seongjun-k/smart-battery-manager/cad/img/back_closed.png

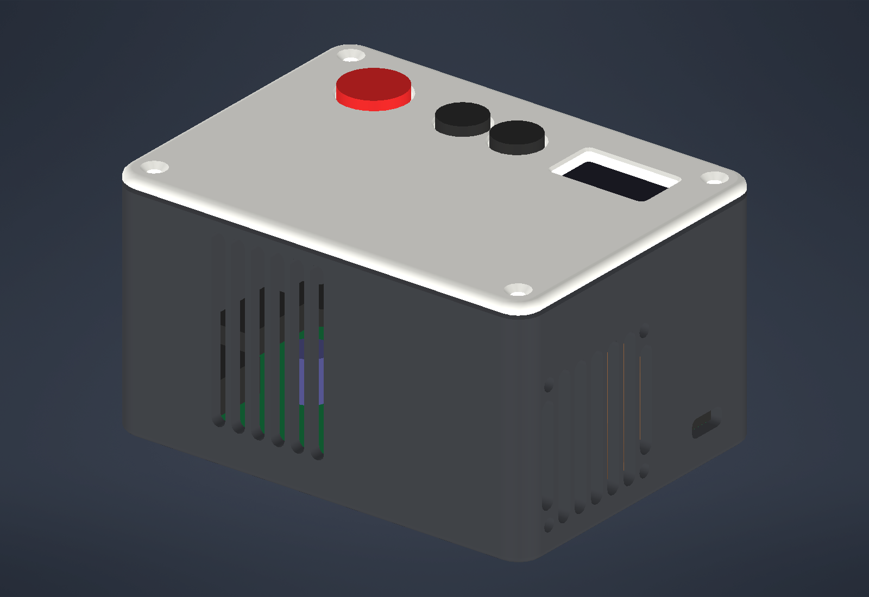
cad/img/back_closed.png
