seongjun-k/smart-battery-manager/cad/img/iso_closed.png

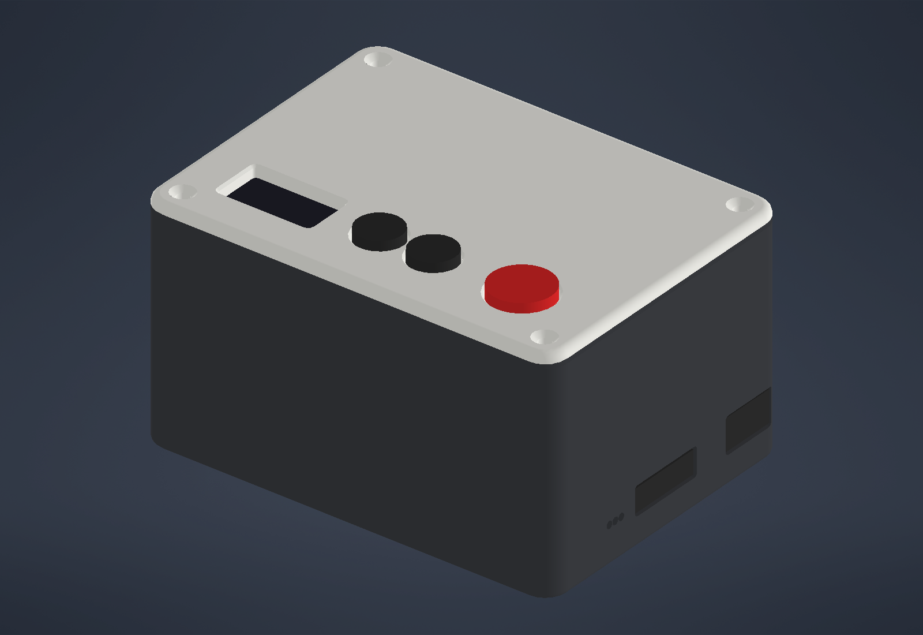
cad/img/iso_closed.png
