seongjun-k/smart-battery-manager/cad/img/top_open.png

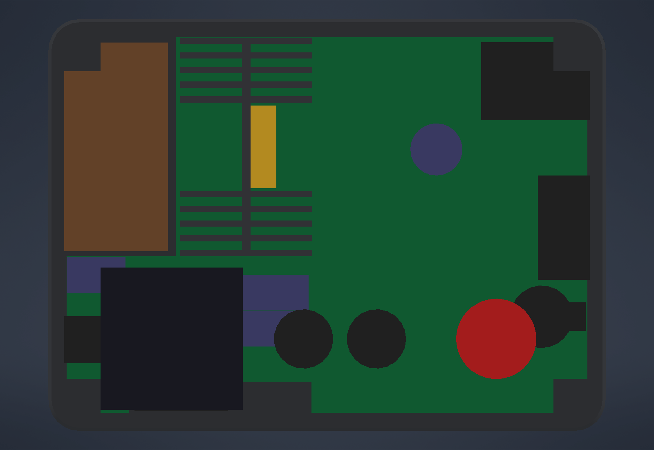
cad/img/top_open.png
