seongjun-k/smart-battery-manager/docs/img/dataflow.png

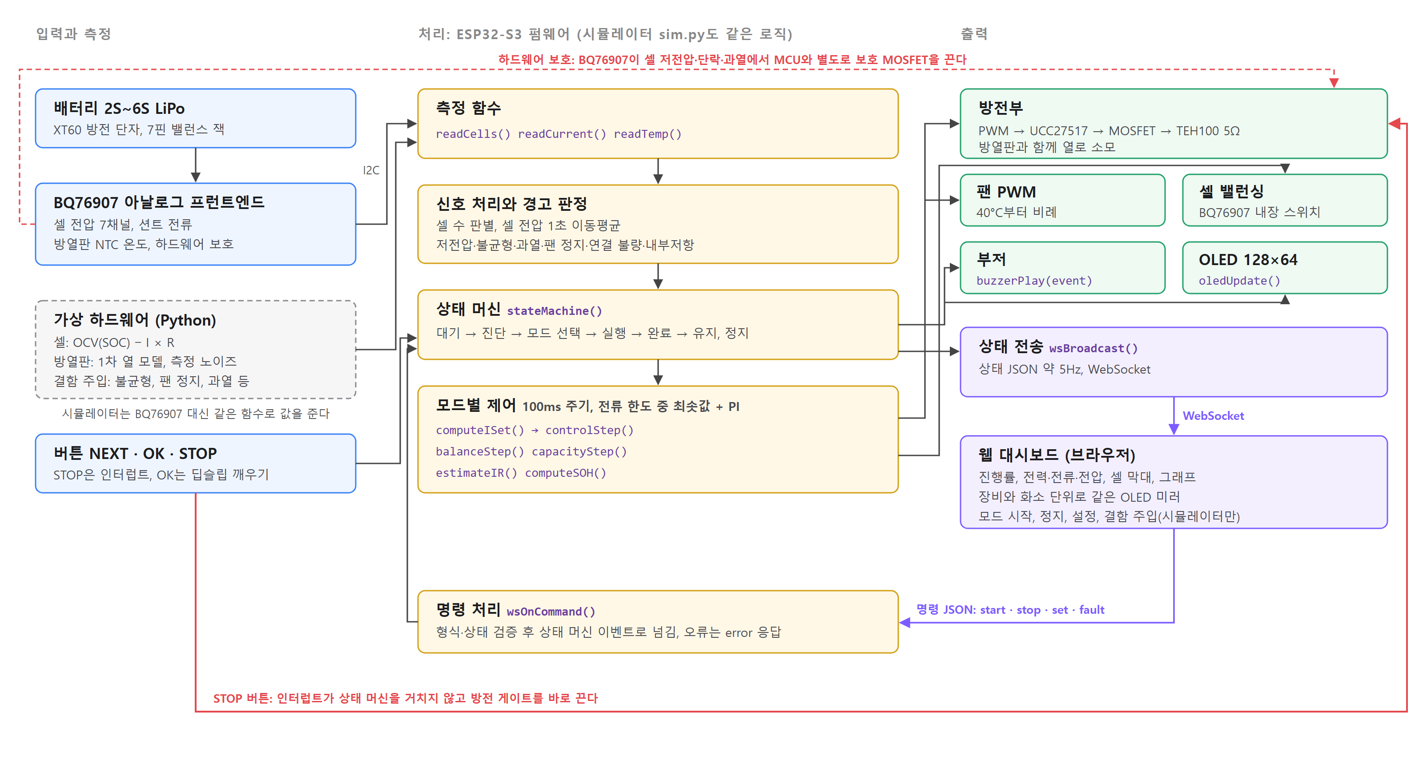
docs/img/dataflow.png
