seongjun-k/smart-battery-manager/docs/img/pcb_3d_bottom.png

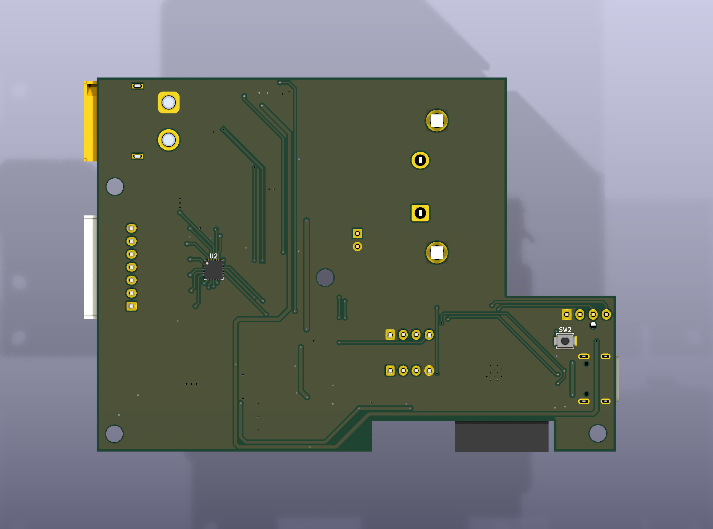
docs/img/pcb_3d_bottom.png
