seongjun-k/smart-battery-manager/docs/img/pcb_3d_top.png

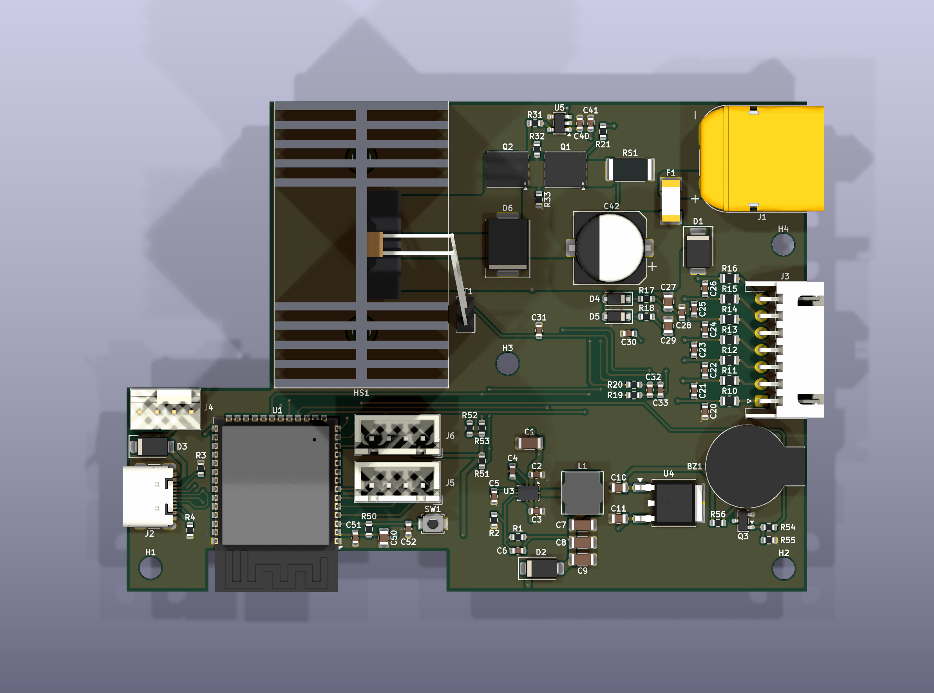
docs/img/pcb_3d_top.png
