seongjun-k/smart-battery-manager/docs/img/pcb_copper_bottom.png

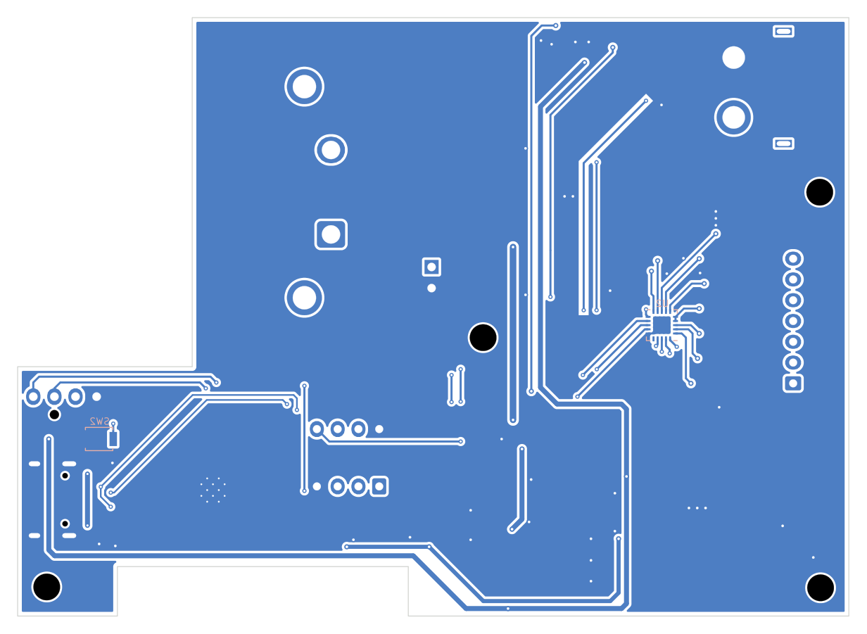
docs/img/pcb_copper_bottom.png
