seongjun-k/smart-battery-manager/docs/img/pcb_copper_top.png

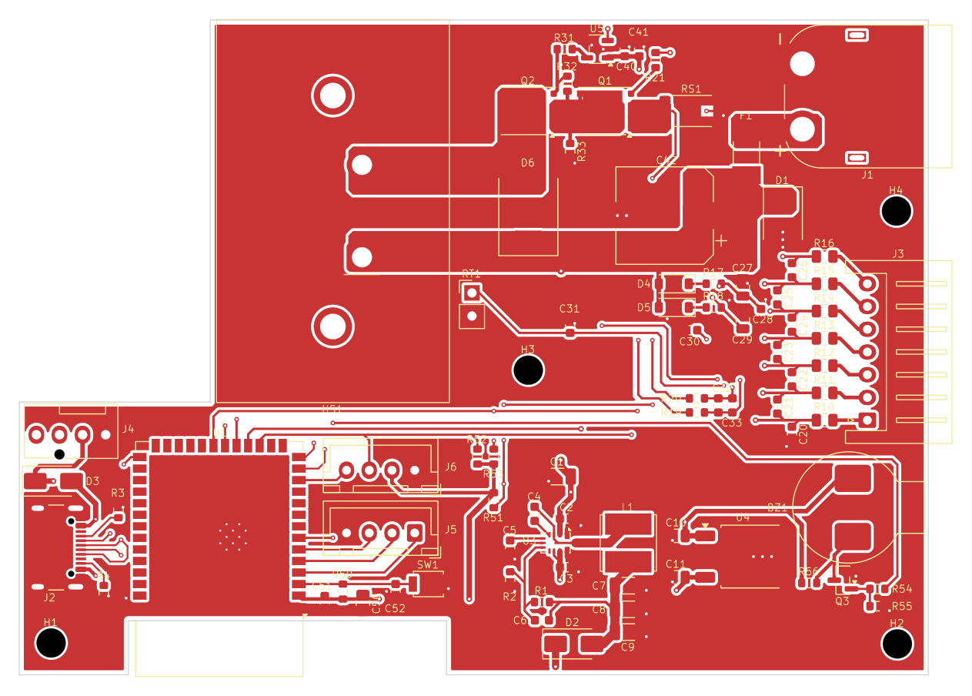
docs/img/pcb_copper_top.png
