seongjun-k/smart-battery-manager/docs/img/web_graph.png

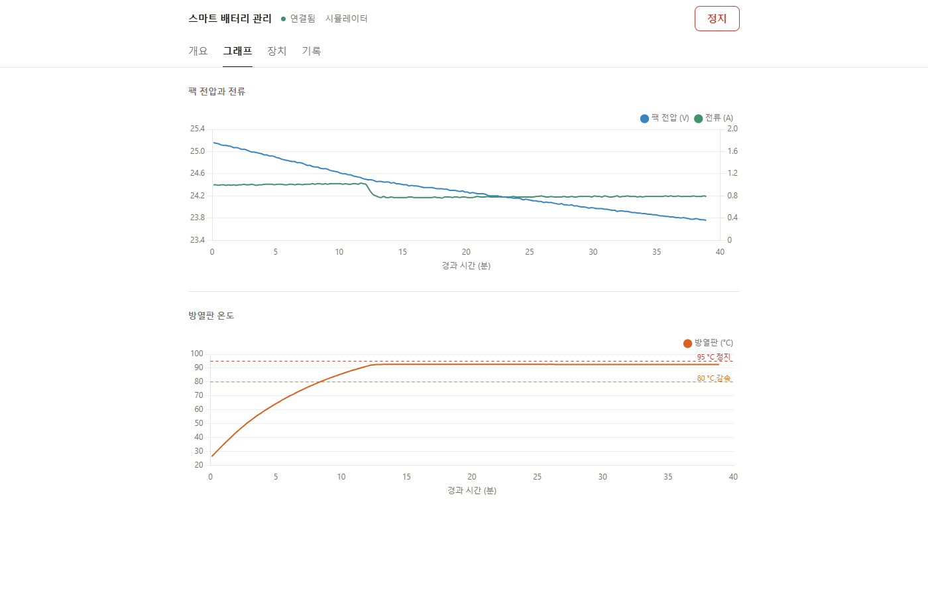
docs/img/web_graph.png
