seongjun-k/smart-battery-manager/docs/img/web_mobile.png

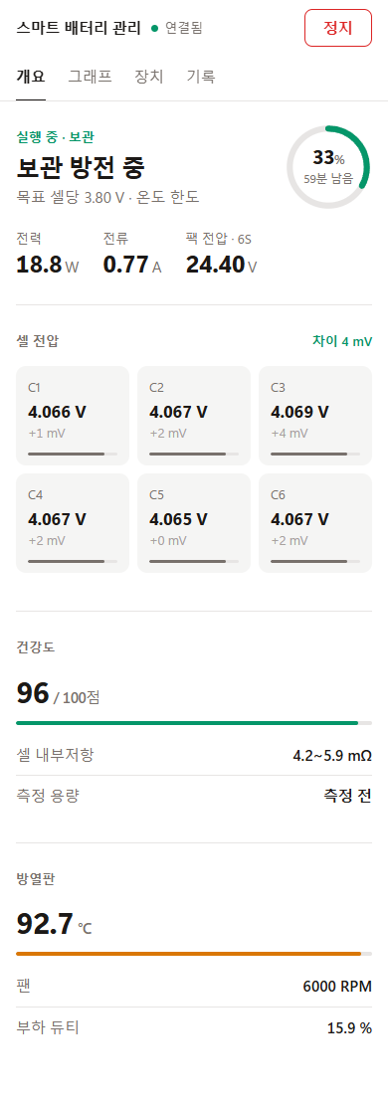
docs/img/web_mobile.png
