seongjun-k/smart-battery-manager/docs/img/web_run.png

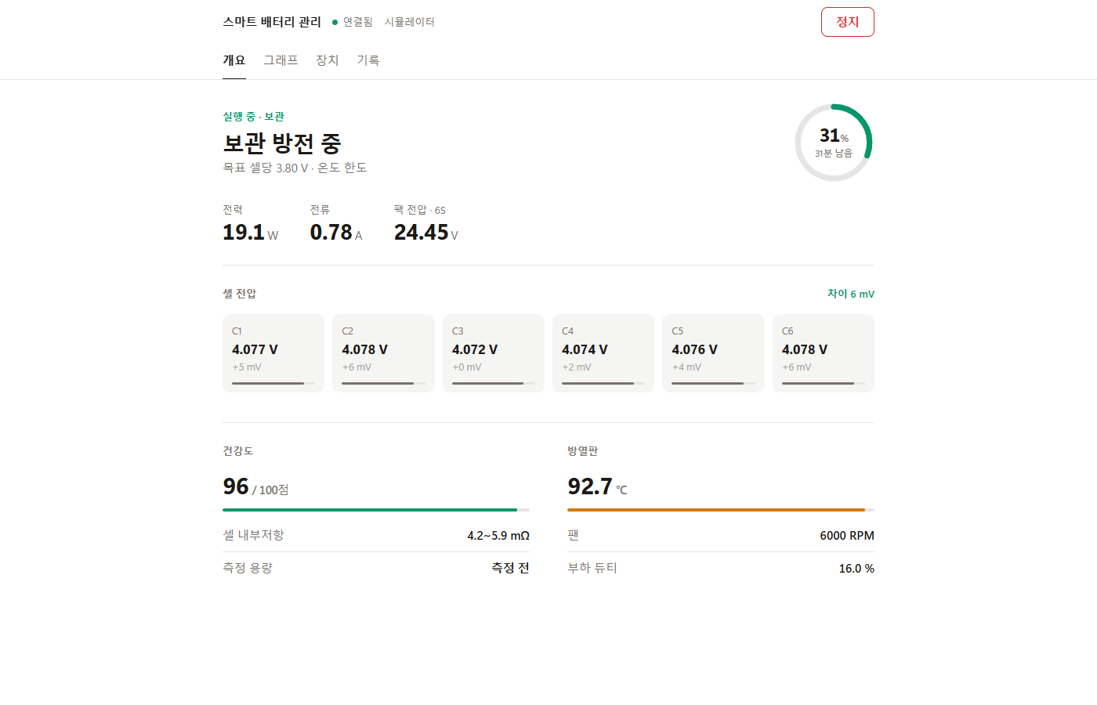
docs/img/web_run.png
