seongjun-k/smart-battery-manager/docs/img/web_select.png

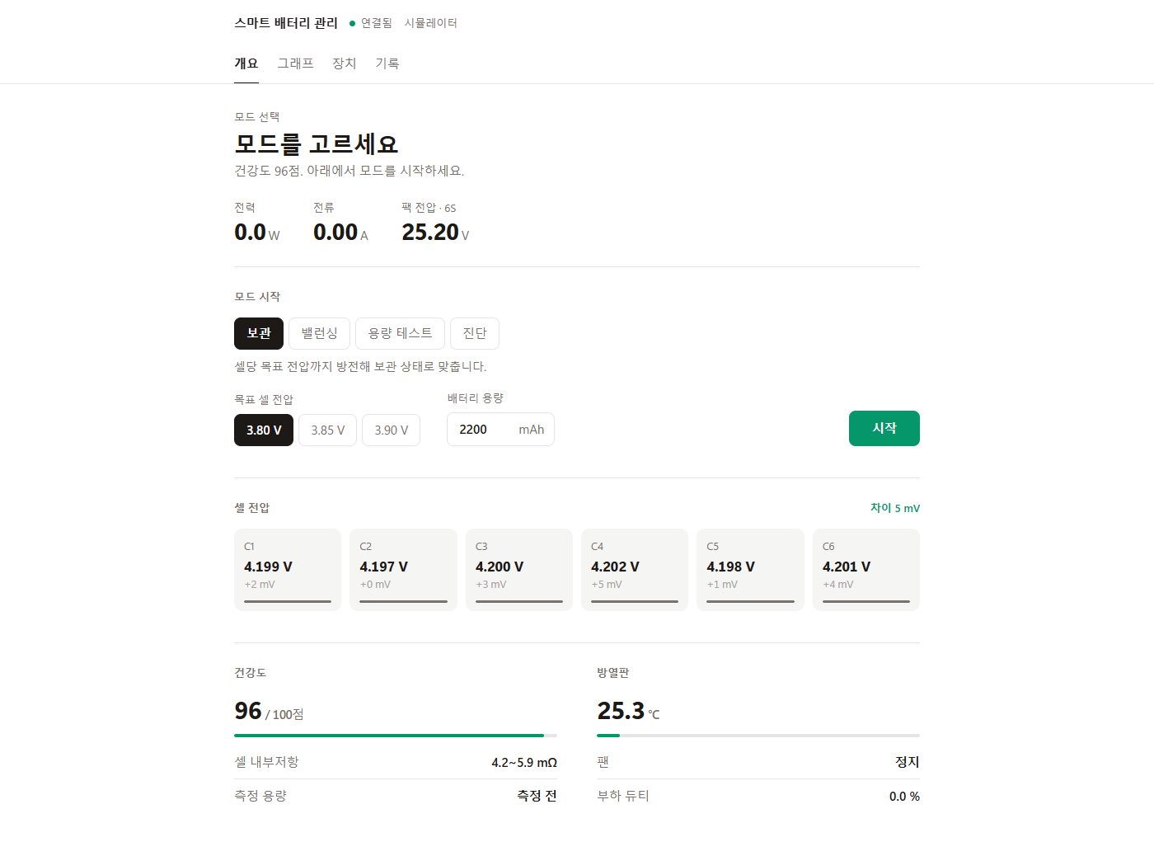
docs/img/web_select.png
