seongjun-k/smart-battery-manager/hw/3d/Fuse_Littelfuse-NANO2-451_453.step

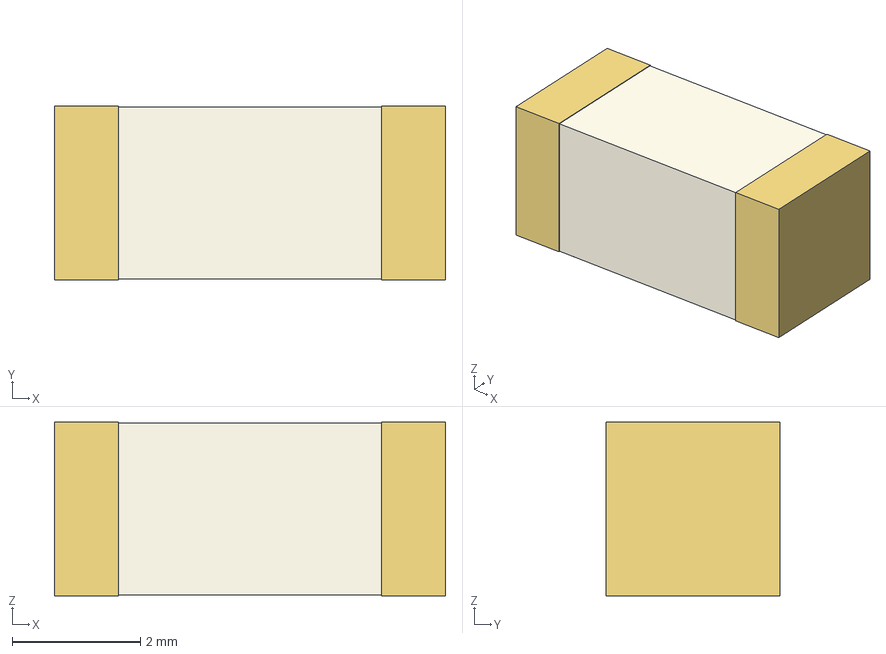
[picture p18: CAD file, 2026-10-30]
hw/3d/Fuse_Littelfuse-NANO2-451_453.step
6.10 x 2.71 x 2.71 mm
ceramic
cap_0
cap_1
