seongjun-k/smart-battery-manager/hw/3d/AMASS_XT60PW-M_1x02_P7.20mm_Horizontal.step

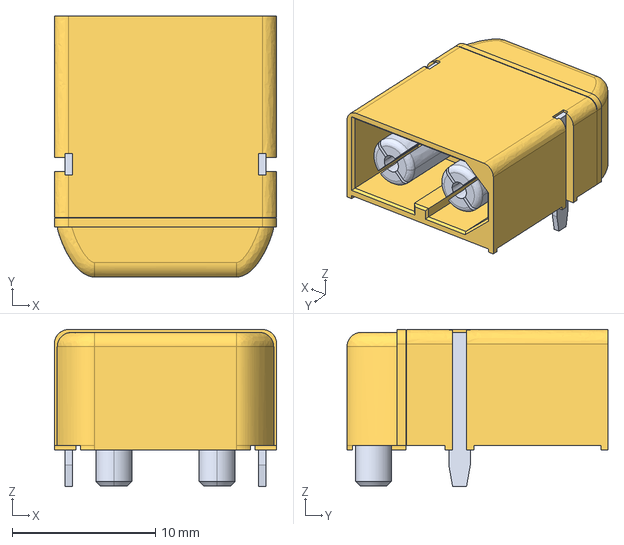
[picture p19: CAD file, 2026-10-30]
hw/3d/AMASS_XT60PW-M_1x02_P7.20mm_Horizontal.step
15.5 x 18.2 x 10.9 mm
