seongjun-k/smart-battery-manager/(list of files, cad)

Other CAD files:
cad/housing.iam
cad/housing_bottom.ipt
cad/housing_lid.ipt
cad/ref_fan.ipt
cad/ref_heatsink.ipt
cad/ref_oled.ipt
cad/ref_parts.ipt
cad/ref_pcb.ipt
cad/ref_resistor.ipt
cad/ref_stop.ipt
cad/ref_tall.ipt
