seongjun-k/smart-battery-manager/firmware/src/hal.h

#pragma once
// 상태 머신·제어 코드가 하드웨어를 보는 유일한 창구.
// 측정원(BQ76907, 이후 다른 AFE)과 출력 방식은 구현 파일(bq76907.cpp, io.cpp)이 숨긴다.
#include "config.h"

enum class Sound : uint8_t { KEY, START, DONE, STOP, WARN, ERROR };

// ---- 측정 (bq76907.cpp, io.cpp) ----
void readCells(float v[MAX_CELLS]);              // [V], 배터리 셀 1~n 순서(BQ 채널이 아님). 못 읽은 칸은 0
float readCurrent();                             // [A], 방전이 +
float readTemp();                                // [°C] 방열판 NTC 하나뿐. 읽기 실패 시 과열 값으로 반환(안전 쪽)
float readFanRpm();

// ---- 출력 (io.cpp, bq76907.cpp) ----
void setLoadDuty(float duty);                    // 0~1
void setFanDuty(float duty);                     // 0~1
void setBalance(const bool bal[MAX_CELLS], int n);   // bal[k] = 배터리 셀 k+1
void setDischargeAllowed(bool on);               // 보호 FET. 진단·실행 중에만 켠다. PWM과 따로 끊는 두 번째 경로
void buzzerPlay(Sound s);
