seongjun-k/smart-battery-manager/(commit log)

2026-10-20 과제 자료와 .gitignore 추가
    docs/에 과제 PDF, 계획서 v3, 결과보고서 초안, 인수인계 문서를 넣는다.
2026-10-20 Python 시뮬레이터 추가, 범위 확정에 맞춰 보고서 초안 갱신
    - sim/: 가상 배터리·열 모델, 제어 로직 이식, WebSocket 서버, 자체 점검
    - 보고서 초안: 이력 DB 제외, 모드 4개, 테스트 8종, 괄호 정리
    - 인수인계: 확정 결정과 남은 작업 갱신, 제출용 HWPX 양식 추가
2026-10-20 시뮬레이터에 밸런싱·용량 테스트 모드 추가, 테스트 8종
    - 밸런싱: 높은 셀만 내장 밸런싱, 1초 이동평균으로 완료 판정
    - 용량 테스트: 정전력 방전, 전하량 적산, 측정 용량을 SOH에 반영
    - batteryId 제거, SOH 식 변경, 과열 결함 +15°C
    - 보고서 7장 테스트 2~4, 6, 7 결과 기록
2026-10-20 웹 대시보드 추가, 시뮬레이터에 진행률·필터·경고 히스테리시스
    - web/: 다크 계기판 + OLED 미러 대시보드, Chart.js 4.5.1 로컬 포함
    - sim: 웹 정적 제공, progress/elapsed/bal/sim 필드, 셀 전압 1초 이동평균,
    불균형 경고 히스테리시스(50/40mV)
    - 보고서 4~7장, 인수인계 갱신
2026-10-20 ESP32-S3 펌웨어 추가, 재연결 필터 버그와 모드 선택 표시 수정
    - firmware/: PlatformIO(espressif32 8.0.0, Arduino 3.3.12), sim.py 제어 로직 이식,
    BQ76952 I2C 드라이버, OLED, AP 모드 웹/WebSocket, STOP ISR
    - 셀 전압 이동평균: 연결이 끊기면 비우고 재연결 시 첫 측정값부터 (sim·펌웨어)
    - 상태 메시지에 selMode 추가, OLED·웹 미러 모드 선택 화면에 표시
    - 보고서 4~7장, 인수인계 하드웨어 주의 사항 갱신
    [config.h, control.cpp, control.h, extra_script.py, hal.h, io.cpp, io.h, main.cpp]
2026-10-20 AFE를 BQ76907로 교체, 하드웨어 결정 반영 (2S~6S, 배터리 NTC 제거)
    - firmware: BQ76907 드라이버(TRM SLUUCJ0), 셀 채널 자동 매핑과 Vcell Mode,
    CUV 3.5V·SCD 8A·OTD 약 70°C·통신 워치독 하드웨어 보호, 완료 10분 뒤 딥슬립
    - sim/firmware/web: 배터리 온도 센서 제거, 밸런싱 동시 3셀(30mA),
    보관 후 자동 밸런싱, 충전 필요(3.70V) 알림, IR 25mΩ 초과 방전 거부, 2S 지원
    - 테스트 10종(IR 거부, 자동 밸런싱 추가)
    - 보고서 3장 부품 재선정(LMR36015, UCC27517, CSD18534Q5A 등), 2~7장, 인수인계 갱신
2026-10-20 방전부를 HS50 + PCB 세움형 방열판으로 바꾸고 Inventor 하우징 추가
    - 방전 저항 Arcol HS50 5Ω 50W 1개, 방열판 Fischer SK 409 63,5 STS, 팬 NF-A4x20 5V PWM
    - 기구를 PCB 한 장 가로 배치로 변경, 흡기 뒷면, 배기 왼쪽 옆면, 덮개에 OLED와 패널 버튼 3개
    - cad/build_housing.py: Inventor COM으로 하부·덮개·확인용 조립품 생성, 간섭 0건, 135x105x92.5mm
    - 보고서 3-1 부품표, 선정 이유, 열 설계, 3-2 크기·배치 갱신
    [housing.iam, housing_bottom.ipt, housing_lid.ipt, ref_fan.ipt, ref_heatsink.ipt, ref_oled.ipt, ref_parts.ipt, ref_pcb.ipt]
2026-10-20 방전 저항을 TEH100(TO-247) + 657-15ABPE로 바꾸고 방열판 기준 80→95°C
    - 방전 저항 Ohmite TEH100M5R00FE 5Ω, 방열판 Wakefield 657-15ABPE(솔더 핀)
    - 방열판 온도 감액 80→95°C, BQ76907 OTD 코드 18(약 96~99°C), sim 열저항 2.6/6.6
    - 보고서 3-1 부품표·선정 이유, 3-2 열 설계·크기 갱신
2026-10-20 KiCad 회로도와 PCB 부품 배치 추가, 하우징을 배치에 맞춤
    - hw/gen_schematic.py: 부품표에서 회로도(A3 4블록), 커스텀 심볼(BQ76907, LMR36015,
    UCC27517, AP7361C-33D)과 풋프린트(TEH100, 657-15ABPE) 생성. ERC 0건
    - 셀 결선을 TRM 표 5-8과 대조, 2S~5S 변환 케이블 결선표를 회로도에 표기
    - PCB 128x98mm(모서리 10mm 따냄), 91개 배치. BQ76907EVM·LMR36015 레이아웃 예 기준
    - 하우징: TO-247 + 657-15ABPE로 낮춘 이전 변경 포함, TEH100 리드 간격 10.16mm,
    PCB 고정 구멍을 팬 아래에서 옮김, ESP32 안테나를 앞 가장자리로. 간섭 0건
    - 인수인계 3~5장 갱신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
    [housing.iam, housing_bottom.ipt, housing_lid.ipt, ref_fan.ipt, ref_heatsink.ipt, ref_oled.ipt, ref_parts.ipt, ref_pcb.ipt]
2026-10-21 PCB 배선 완료, 미확정 부품 사양 확인 반영
    - 45° 자동 배선기 hw/autoroute45.py 추가, 전 넷 배선 + B.Cu GND 면
    - BQ76907을 아래면으로 옮겨 셀 배선 교차 제거, 노출 패드는 비아로 GND 연결
    - 벅 SW·VIN 구간을 레이아웃 예대로 손배선, C1·C2 방향 변경
    - 실크 참조 문자 재배치, 3D 모델 복구, 최소 홀 0.2mm (ESP32 열 비아)
    - 방열판 핀 위치, 팬 PWM, 퓨즈·다이오드·인덕터·NTC 사양을 데이터시트로 확정
    - 하우징 방열판을 657 실제 단면으로 다시 생성 (간섭 0건)
    - BQ76907 전류 갱신 주기 2.93ms 확인
    [housing.iam, housing_bottom.ipt, housing_lid.ipt, ref_fan.ipt, ref_heatsink.ipt, ref_oled.ipt, ref_parts.ipt, ref_pcb.ipt]
2026-10-22 회로도·PCB 100x72·하우징 전면 재설계, 부저를 BRS-03SC 피에조로 교체
    - 회로도를 블록 단위 실제 선으로 다시 그림 (ERC 0)
    - PCB 128x98 -> 100x72mm 재배치, 손배선 묶음(route_hand.py) + 45도 라우터로 재배선 (DRC 오류 0, 미연결 0)
    - 커넥터 J4/J5/J6/BZ1 가로 핀 줄 통일, 팬 커넥터를 USB 쪽으로, D2/D3 안쪽, 실크 0도 0.8mm 통일
    - 부저 BUJEON BRS-03SC 12mm 피에조 + XH 2핀 케이블, D7 대신 병렬 R56, TACH 풀업 R34 제거
    - 하우징 106x78x54.5 재생성 (간섭 0), 오른쪽 벽 소리 구멍
    [housing.iam, housing_bottom.ipt, housing_lid.ipt, ref_fan.ipt, ref_heatsink.ipt, ref_oled.ipt, ref_parts.ipt, ref_pcb.ipt]
2026-10-22 웹 대시보드 전면 재디자인, OLED 미러를 펌웨어 U8g2 글꼴로 화소 단위 일치
    - 계측기 앞판형 배치: 상태 흐름, 진행률 원형 막대, 전류 한도 표시, 팩 전압·전류 추세
    - 셀 세로 막대에 목표·3.50V 차단선, 최고·최저·밸런싱 표시
    - 장비 그림(OLED + NEXT/OK/STOP 버튼), 화면 구성 목록
    - 방열판 온도 그래프에 80°C 감속·95°C 차단선, 온도 구간 막대, 팬 회전 표시
    - 시작 불가 상태면 시작 버튼을 막고 이유 표시, 휴대폰 배치
    - tools/gen_oledfont.py: U8g2 5x8·6x12 글꼴을 web/oledfont.js로 풀어 넣음
    - 밸런싱 진행률을 완료 판정과 같은 이동평균 기준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
2026-10-22 보고서 그림 생성(회로도, PCB 배치·배선·3D, 데이터 흐름도, 웹 화면)과 보고서 빈칸 채우기
    - tools/export_figures.py: 회로도 PDF·PNG, 윗면/아랫면 합친 배치도, 배선도, 3D 3장, dataflow.svg -> png
    - HS1 방열판·R30 TEH100에 하우징 치수 상자 3D 모델(hw/3d, gen_schematic.py가 생성)
    - 하우징 첫 캡처에 남던 초록 강조 제거(버리는 캡처 1회), 간섭 0 재확인
    - 보고서: 3-2 그림 연결, 테스트 포인트 대신 커넥터 핀 측정으로 정정, 4장 실제 코드 발췌,
    5장 화면, 6장 흐름도·high_ir, 7장 오류·한계, 8장 개발 과정·수정 사례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
    [housing.iam, housing_bottom.ipt, housing_lid.ipt, ref_fan.ipt, ref_heatsink.ipt, ref_oled.ipt, ref_parts.ipt, ref_pcb.ipt]
2026-10-22 보고서 마크다운을 제출 양식 HWPX에 채우는 변환기 추가
    - tools/build_hwpx.py: 양식 복사본에 1쪽 안내를 빼고, 양식 항목명·표를 유지한 채 내용·표 행·그림(BinData)을 넣음
    - 그림 hp:pic은 python-hwpx 6.8.0 구조 사용, 결과는 python-hwpx 검사기(구조·스키마·재열기)로 확인
    - 보고서 그림 참조를 마크다운 이미지로 바꾸고 휴대폰 화면은 첫 화면만 자름
    - docs/결과보고서_제출본.hwpx 생성 (한글에서 렌더링 확인 전)
2026-10-22 ESP32 안테나 따냄을 Espressif 여유 영역 그림에 맞춰 넓히고 재배선
    - 앞 따냄 x 112~132, y 165.6 -> x 112~147, y 166.05 (급전점 반대쪽 모듈 끝에서 15mm 비움, 안테나 시작선부터)
    - C50·C51 0.4mm 위로, +5V 아래면 줄 y 164.75·x 147.6에서 꺾음, 3.3V 아래면 줄 x 149.5까지 간 뒤 내려감
    - DRC 오류 0, 미연결 0, 45도 위반 0, 하우징 간섭 0 (106x78x54.5 그대로)
    - 보고서 그림·제출본 HWPX 다시 생성, 인수인계 [확인 필요] 해소
    [housing.iam, housing_bottom.ipt, housing_lid.ipt, ref_fan.ipt, ref_heatsink.ipt, ref_oled.ipt, ref_parts.ipt, ref_pcb.ipt]
2026-10-22 웹 대시보드를 단순한 화면으로 다시 정리 (개요·그래프·장치·기록 탭, 시작 칸은 시작 가능할 때만)
2026-10-22 보고서 5장 웹 설명과 스크린샷을 탭형 v4 화면에 맞춰 갱신
    - 5장: 개요·그래프·장치·기록 탭 구조로 다시 쓰고 v3 계기판·장비 그림 설명 삭제
    - web_run·web_select·web_mobile 다시 캡처 (시뮬레이터 60배속, 콘솔 오류 0)
    - 3장 열 설계 [확인 필요]를 문장으로 풀고 제출본 HWPX 재생성
    - 인수인계 현황 갱신
2026-10-22 시뮬레이터 방열 열저항을 실제 방열판 값 3.6°C/W로 바꾸고 보고서의 25W 표현을 상한으로 정리
    - R_TH_FAN 2.6(요구치) → 3.6(657-15ABPE 송풍 3.3 + 서멀 층). 보관 방전은 처음 약 12분 25W, 이후 I_T가 약 19W·방열판 약 93°C로 유지
    - 보고서 "평균 25W"를 "최대 25W"로, 방전 시간 예·열 모델·테스트 1·6 결과 수치 갱신
    - test_sim.py 10종 그대로 통과 (assert 변경 없음)
2026-10-22 하우징 공기 경로 재설계: 팬 공기가 모두 방열판 핀을 지나게
    - 흡기 뒷면 슬롯 5개 568mm² → 6개 약 830mm², 배기 왼쪽 벽 6개 672mm² → 7개 약 900mm² (팬 날개 고리 약 930mm²)
    - 덮개: 방열판·팬-방열판 틈 위를 덮는 판, 팬 앞 칸막이(J4 위에서는 그 위까지)
    - 바닥: 팬 자리 따냄 오른쪽·앞 가장자리 막이 (PCB 아래 틈으로 새는 길 차단)
    - 간섭 0건, 외곽 106×78×54.5mm 그대로. PCB 배치는 흡기→FET→방열판→팬이 이미 일직선이라 변경 없음
    - 보고서 팬 설명(빨아내는 방식)과 3-2 공기 경로 문단 갱신, 제출본 재생성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
    [housing.iam, housing_bottom.ipt, housing_lid.ipt, ref_fan.ipt, ref_heatsink.ipt, ref_oled.ipt, ref_parts.ipt, ref_pcb.ipt]
2026-10-22 독립 검토 반영: 정지 시 보호 FET 차단, 셀 채널 패턴 검사, 게이트 드라이버 전원 마진
    - 펌웨어: setDischargeAllowed() 추가, 진단·실행 중에만 BQ76907 DSG 허용. PWM FET 고장에도 정지·보호가 전류를 끊음
    - 펌웨어: countCells()가 DS 표 7-1 셀 수 패턴과 정확히 맞을 때만 셀 수 인정. 방전 셀·빠진 선을 적은 셀 수로 오판해 Vcell Mode(하드웨어 CUV)를 바꾸던 문제 수정. 6S 주석의 단락 채널 번호(6→4) 정정
    - 펌웨어 measure(): 낮은 전압의 최상위 셀도 셀 목록에 남겨 UNDERVOLT가 걸리게 (sim과 동일)
    - 시뮬레이터: 보호 FET 경로와 PWM FET 단락 모델, 테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
    [smart_bms.kicad_pcb, smart_bms.kicad_sch]
2026-10-22 전체 검토 반영: 진단 트립 검사, 하우징 공기 경로 2차(방열판 위 플레넘), R2 22.6k, 보고서 정정
    - 펌웨어·시뮬레이터: 진단 상태에서 저전압·과열·팬 정지면 펄스 생략, 새 배터리 연결 시 IR·SOH 초기화,
    배터리 없이 start 거부, readCurrent 실패 시 직전 값 유지, readTemp 재시도. 테스트 12 추가
    - 하우징: 657 세로판이 X 방향 흐름을 막으므로 방열판 위 약 10mm 공간을 두고 둘레를 벽으로 막아
    +X 핀 → 위 → -X 핀 → 팬 경로로 바꿈. H_SHELL 56, 칸막이 J4 위 케이블 틈, 간섭 0건
    - 회로: R2 23.7k → 22.6k (최악 5.29V - D2 강하 > UCC27517 VON 4.65V, +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
    [housing.iam, housing_bottom.ipt, housing_lid.ipt, ref_fan.ipt, ref_heatsink.ipt, ref_oled.ipt, ref_parts.ipt, ref_pcb.ipt]
2026-10-22 웹 대시보드 4차: 흰 바탕, 가는 구분선, 강조색 하나로 다시 정리
    - 상자 중첩을 없애고 여백과 구분선으로만 칸을 나눈다. 셀 전압은 6열 작은 칸(휴대폰 3열)
    - 진행률 원과 정지 버튼은 실행·진단 중에만 표시
    - 보고서 5장 설명과 스크린샷 3장, 제출본 HWPX 갱신
2026-10-22 하우징 외관 정리: 벽 3mm, 바깥 모서리 R6·덮개 R2·바닥 R1.5 모깎기, 통풍 슬롯 끝 반원
    [housing.iam, housing_bottom.ipt, housing_lid.ipt, ref_fan.ipt, ref_heatsink.ipt, ref_oled.ipt, ref_parts.ipt, ref_pcb.ipt]
2026-10-22 부저 BRS-03SC를 PCB에 표면 실장: 풋프린트·3D 모델 추가, J3 아래 배치와 구동부 재배치, 재배선, 하우징 소리 구멍을 탭 높이로
    [housing.iam, housing_bottom.ipt, housing_lid.ipt, ref_fan.ipt, ref_heatsink.ipt, ref_oled.ipt, ref_parts.ipt, ref_pcb.ipt]
2026-10-22 하우징 제품 외관: 조작부 한 줄 정렬과 빨간 STOP, 두 색, 새긴 글자, 이음선 V홈, 접시머리 나사, 창·단자 구멍 마감, 고무발 자리
    [housing.iam, housing_bottom.ipt, housing_lid.ipt, ref_fan.ipt, ref_heatsink.ipt, ref_oled.ipt, ref_parts.ipt, ref_pcb.ipt]
2026-10-22 하우징 글자 새김 제거 (사용자 결정)
    [housing.iam, housing_bottom.ipt, housing_lid.ipt, ref_fan.ipt, ref_heatsink.ipt, ref_oled.ipt, ref_parts.ipt, ref_pcb.ipt]
2026-10-22 gitignore: 과제 원본·계획서, .mcp.json, 로그 제외
2026-10-26 쓰지 않는 웹 스크린샷 web_mobile_full.png 삭제
2026-10-30 PCB 3D 모델이 빠진 6개 부품 대체: Q1·Q2 WSON-8 6x5, U2 QFN-20 축소, U3 상자, J1·F1 외부 STEP, 3D 그림 재생성
    KiCad 10.0.1 라이브러리에 해당 STEP 파일이 없어 보고서 3D 그림에 패드만 보이던 문제.
    J1·F1 STEP 출처와 확인 방법은 인수인계 7장에 적었다.
    [AMASS_XT60PW-M_1x02_P7.20mm_Horizontal.step, Fuse_Littelfuse-NANO2-451_453.step, smart_bms.kicad_pcb]
2026-11-07 PCB: 전류 감지 필터를 U2 옆으로, 벅 입력 C를 VIN·GND 핀 쌍에 붙임
    - R19·R20·C32·C33을 RS1 옆에서 U2 위 윗면으로 옮김 (BQ76907 DS 10.1: 필터는 IC 가까이)
    - RS1 두 패드 안쪽에서 켈빈 선 둘을 따로 뽑고, GND 켈빈 선 둘레에 존 채움 금지 영역(KELVIN_GND_*)을 둬 GND 면과 분리
    - C2·C3을 0°로 돌려 VIN 패드를 VIN 핀 쪽, GND 패드를 GND 핀 쪽으로 붙임 (LMR36015 DS 12.1)
    - 자동배선 GND 비아가 켈빈 선을 피하게 kelvin 표시 추가
    - DRC 오류 0·미연결 0, 보드 그림과 제출본 HWPX 재생성
    [smart_bms.kicad_pcb]
2026-11-07 PCB 3D: TEH100 장착 구멍, 부저 원통, 방열판 NTC 모델 추가
    - write_wrl이 상자 외에 원통(cyl), 구멍 뚫린 판(holed), 선(wire)도 만들게 확장
    - R30 TEH100에 M3 장착 구멍 Ø3.63 (Ohmite TEH100 rev 7/25-1, 3.53~3.73mm)
    - BZ1 부저를 계단 상자 대신 64각 원통으로
    - RT1에 두 번째 모델 Semitec_103AT-2_on_HS1.wrl: 방열판 세로판 R30 위 NTC 머리, 리드선, 2핀 소켓 (머리 높이·색은 추정)
    - 3D 그림 3장과 제출본 HWPX 재생성
    [smart_bms.kicad_pcb]
2026-11-07 PCB 실크: 참조 문자를 한 규칙으로 재배치 (hw/place_refs.py)
    - 0.8mm, 부품 몸체(F.Fab·패드·부품 실크) 바로 위 → 아래 → 왼쪽 → 오른쪽 중 처음 비는 자리
    - 한 줄로 늘어선 같은 부품은 같은 쪽, 글자에서 가장 가까운 부품이 자기 부품일 것
    - 0° 자리가 없는 세로 부품은 옆에 90° 글자
    - 자리가 없는 D3·SW2·R32·R11~R15는 숨김 (R16·R10이 열의 끝 표시)
    - F.Fab 이름은 몸체 가운데에 0°/90°로 바로 읽히게
    - 배치도의 아랫면 U2 이름표를 C32 글자와 겹치지 않게 왼쪽으로
    - 실크 겹침 0, 미연결 0. 그림과 제출본 HWPX 재생성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
    [smart_bms.kicad_pcb]
2026-11-07 PCB: 숨겼던 참조 문자 8개 자리 확보 (부품 이동·재배선)
    - 셀 필터 R10~R16 간격 2.5 → 3.0mm (y 126~144), J3와는 45°로 맞춤.
    C20~C26은 줄 사이 두 열, 줄마다 R → 비아 → 아래면 U2로 재배선
    - SW2(BOOT)를 아래면으로, IO0은 비아로. D3 오른쪽이 D3 이름 자리
    - R31을 1mm 올려 R32 이름 자리
    - place_refs: 세로 부품은 위·아래가 막히면 옆 90°를 0°보다 먼저
    - 배치도 아랫면 부품 이름(U2, SW2)을 보드 파일 위치로 단다
    - DRC 오류 0, 미연결 0. 그림·제출본 HWPX 재생성
    [smart_bms.kicad_pcb]
2026-11-08 보고서·인수인계 문서를 저장소에서 제외 (.gitignore)
2026-11-08 테스트 9: IR 높은 배터리의 밸런싱 시작 거부도 확인
2026-11-08 README 추가
2026-11-08 .gitignore: 보고서 PDF 제외
2026-11-08 .gitignore: 보고서용 배터리 사진 제외
2026-11-08 브라우저 시뮬레이터(Pyodide)를 GitHub Pages로 배포, OLED 화면 그림 추가
2026-11-08 웹 그래프 탭 캡처 추가(보관 방전 39분)
